agri-cruiser/agri-cruiser/docs/figures/Intro_Figure.jpeg

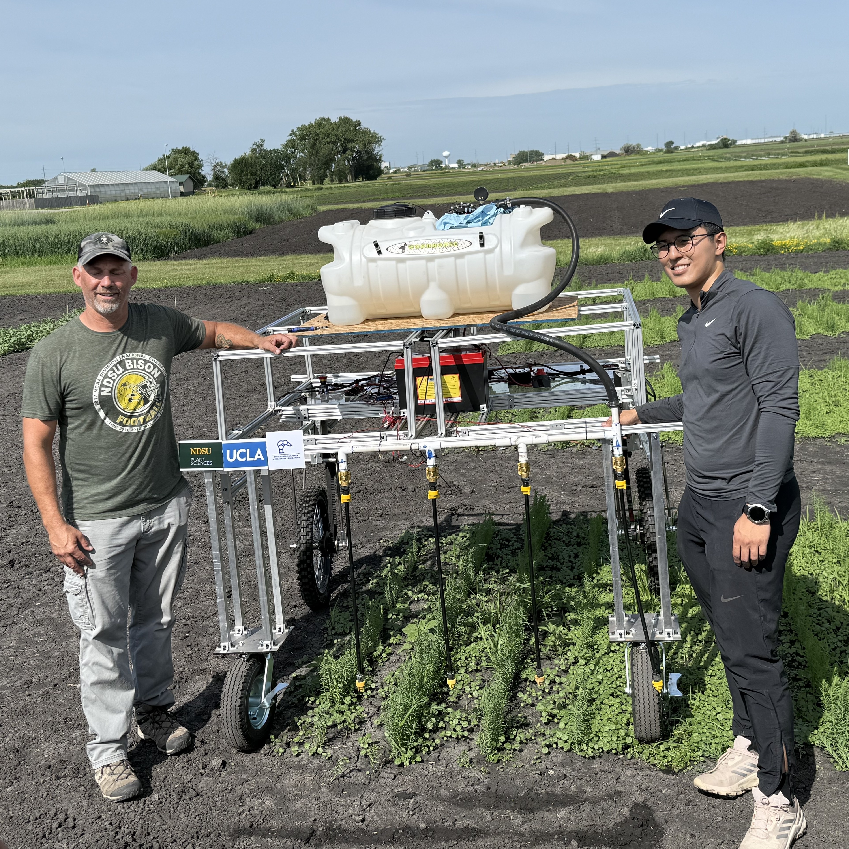
docs/figures/Intro_Figure.jpeg
