agri-cruiser/agri-cruiser/docs/figures/Jason_Irie.webp

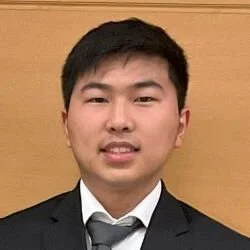
docs/figures/Jason_Irie.webp
