agri-cruiser/agri-cruiser/docs/figures/Jony_Mohammad.jpg

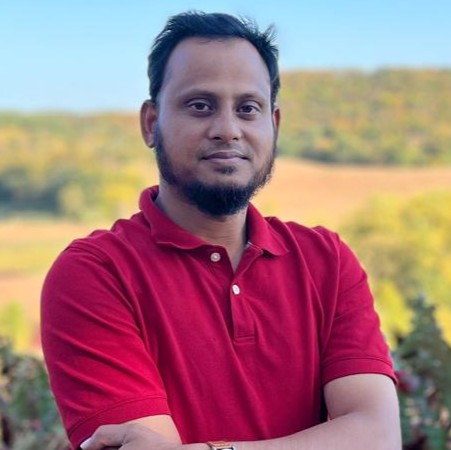
docs/figures/Jony_Mohammad.jpg
