agri-cruiser/agri-cruiser/docs/figures/Kenny_Truong.webp

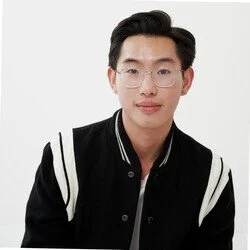
docs/figures/Kenny_Truong.webp
