agri-cruiser/agri-cruiser/docs/figures/Khalid_Jawed.jpg

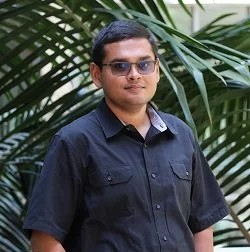
docs/figures/Khalid_Jawed.jpg
