agri-cruiser/agri-cruiser/docs/figures/Main.jpg

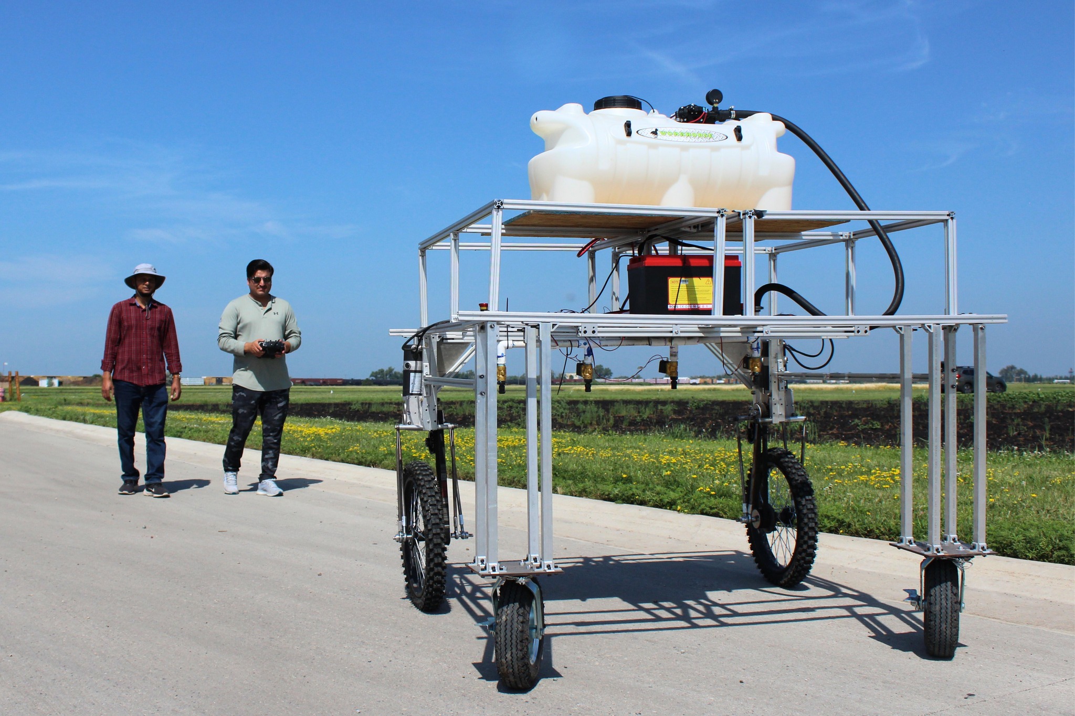
docs/figures/Main.jpg
