agri-cruiser/agri-cruiser/docs/figures/Mukhlesur_Rahman.png

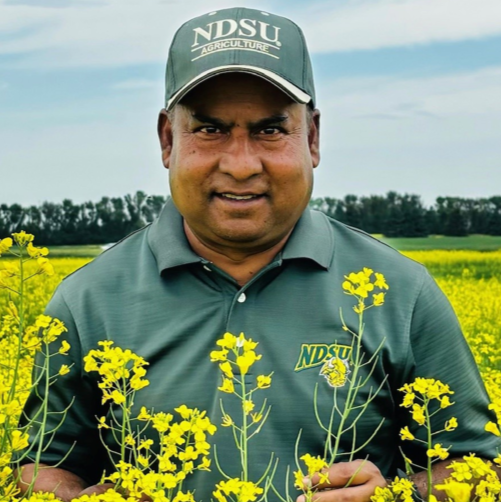
docs/figures/Mukhlesur_Rahman.png
