agri-cruiser/agri-cruiser/docs/figures/Overview.png

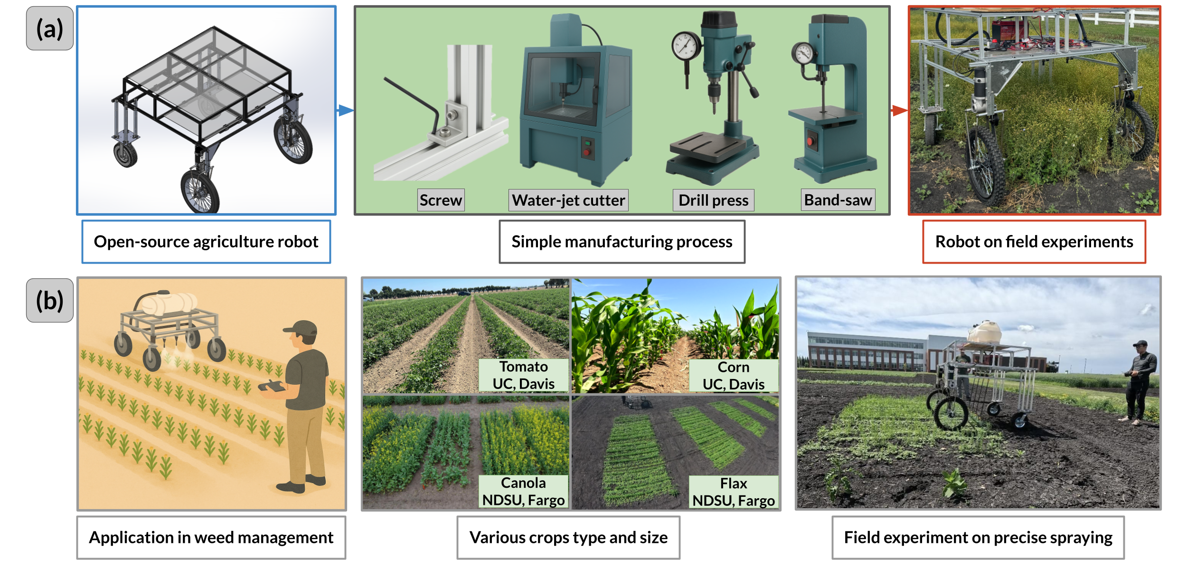
docs/figures/Overview.png
