agri-cruiser/agri-cruiser/docs/figures/Shahab_Ahmad.jpg

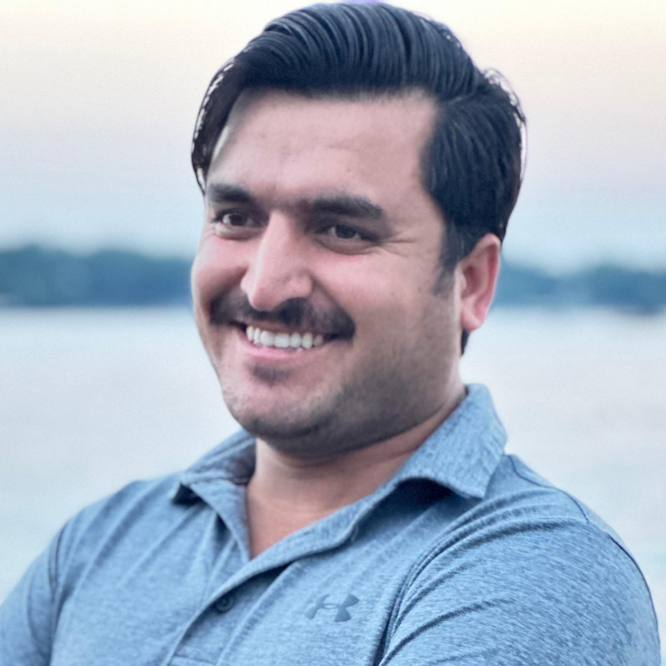
docs/figures/Shahab_Ahmad.jpg
