agri-cruiser/agri-cruiser/docs/figures/Shivam_Panda.webp

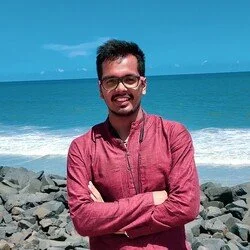
docs/figures/Shivam_Panda.webp
