agri-cruiser/agri-cruiser/docs/figures/Yongkyu_Lee.webp

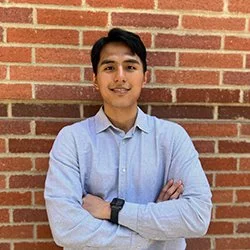
docs/figures/Yongkyu_Lee.webp
