agri-cruiser/agri-cruiser/ESP32-Code/MainRobotCode.ino

#include <esp_now.h>
#include <WiFi.h>
#include "RoboClaw.h"
#include <HardwareSerial.h>

// Relay pins for solenoid control
#define RELAY_PIN1  5
#define RELAY_PIN2  18
#define RELAY_PIN3  19
#define RELAY_PIN4  21

// RoboClaw motor controller address
#define ROBOCLAW_ADDR 0x80

// UART2 for RoboClaw (pins 16 = RX, 17 = TX) to communicate with RoboClaw
HardwareSerial serial2(2); 
RoboClaw roboclaw(&serial2, 10000);

// MAC address of peer ESP32 for ESP-NOW communication (Optional if wanting to communicate with other ESP32)
uint8_t receiverAddress[] = { 0xAC, 0x15, 0x18, 0xD8, 0xD0, 0xD8 };

// Struct for incoming motor + solenoid commands to recieve commands
typedef struct struct_message {
  int speed1;
  int speed2;
  bool solenoid1;
  bool solenoid2;
  bool solenoid3;
  bool solenoid4;
} struct_message;

// Struct for outgoing telemetry (encoders, voltage, motor speeds) 
typedef struct struct_message1 {
  int enc1;
  int enc2;
  float voltage;
  float speedL;
  float speedR;
} struct_message1;

struct_message1 sendingData;
struct_message incomingData;

// Status LED pin (optional)
const int ledPin = 2;

// Encoder counts per revolution
#define CPR 4000  // 1000 lines * 4 (quadrature)

// Motor control scaling constants
int MAX_SPEED = 35000;
int MAX_TURN = 35000;
int MAX_PWM_F = 64;
int MAX_PWM_T = 32; 

// Buffer for CRSF packets from RC receiver
uint8_t crsfBuffer[64];
int crsfPos = 0;

// Callback for handling incoming ESP-NOW data
void onDataRecv(const uint8_t *mac, const uint8_t *incomingDataRaw, int len) {
  memcpy(&incomingData, incomingDataRaw, sizeof(incomingData));

  // Print received data for debugging
  Serial.printf("M1: %d, M2: %d\n", incomingData.speed1, incomingData.speed2);

  // Control motors based on received speeds from ESP32 
  if(incomingData.speed1 < 0){
    roboclaw.SpeedM1(ROBOCLAW_ADDR, incomingData.speed1);
  }else{
    roboclaw.SpeedM1(ROBOCLAW_ADDR, incomingData.speed1);
  }

  if(incomingData.speed2 < 0){
    roboclaw.SpeedM2(ROBOCLAW_ADDR, incomingData.speed2);
  }else{
    roboclaw.SpeedM2(ROBOCLAW_ADDR, incomingData.speed2);
  }

  // If speed is zero, ensure motor is stopped
  if(incomingData.speed1 == 0){
    roboclaw.ForwardM1(ROBOCLAW_ADDR, 0);
  }
  if(incomingData.speed2 == 0){
    roboclaw.ForwardM2(ROBOCLAW_ADDR, 0);
  }
  
  // Read encoder values
  uint32_t enc1, enc2;
  bool valid1, valid2;
  enc1 = roboclaw.ReadEncM1(ROBOCLAW_ADDR, NULL, &valid1);
  enc2 = roboclaw.ReadEncM2(ROBOCLAW_ADDR, NULL, &valid2);

  // Read battery voltage
  bool valid3;
  uint16_t volts = roboclaw.ReadMainBatteryVoltage(ROBOCLAW_ADDR);

  // Prepare telemetry data
  struct_message1 telemetry;
  telemetry.enc1 = valid1 ? enc1 : -1;
  telemetry.enc2 = valid2 ? enc2 : -1;

  float x = volts/10.0;

  telemetry.voltage = x;

  // Solenoid control through relay pins
  if(incomingData.solenoid1){
    digitalWrite(RELAY_PIN1, HIGH);  // Turn relay OFF (active-low relay)
  }
  else{
    digitalWrite(RELAY_PIN1, LOW);
  }
  if(incomingData.solenoid2){
    digitalWrite(RELAY_PIN2, HIGH);  // Turn relay OFF (active-low relay)
  }
  else{
    digitalWrite(RELAY_PIN2, LOW);
  }
  if(incomingData.solenoid3){
    digitalWrite(RELAY_PIN3, HIGH);  // Turn relay OFF (active-low relay)
  }
  else{
    digitalWrite(RELAY_PIN3, LOW);
  }
  if(incomingData.solenoid4){
    digitalWrite(RELAY_PIN4, HIGH);  // Turn relay OFF (active-low relay)
  }
  else{
    digitalWrite(RELAY_PIN4, LOW);
  }

  // Read motor speeds in counts/sec
  bool valid4, valid5;
  int32_t speed1 = roboclaw.ReadSpeedM1(ROBOCLAW_ADDR,NULL, &valid4);  // counts/sec
  int32_t speed2 = roboclaw.ReadSpeedM2(ROBOCLAW_ADDR,NULL, &valid5);  // counts/sec

  telemetry.speedL = speed1;
  telemetry.speedR = speed2;

  // Send back to sender
  esp_now_send(mac, (uint8_t *)&telemetry, sizeof(telemetry));
}

void setup() {
  Serial.begin(115200);

  // Initialize Serial1 for CRSF receiver (pins 22 = RX, 23 = TX)
  Serial1.begin(420000, SERIAL_8N1, 22, 23); // CRSF UART

  // Initialize relay pins
  pinMode(RELAY_PIN1, OUTPUT);     // Set the relay pin as output
  digitalWrite(RELAY_PIN1, LOW);  // Turn relay OFF (active-low relay)

  pinMode(RELAY_PIN2, OUTPUT);     // Set the relay pin as output
  digitalWrite(RELAY_PIN2, LOW);  // Turn relay OFF (active-low relay)

  pinMode(RELAY_PIN3, OUTPUT);     // Set the relay pin as output
  digitalWrite(RELAY_PIN3, LOW);  // Turn relay OFF (active-low relay)

  pinMode(RELAY_PIN4, OUTPUT);     // Set the relay pin as output
  digitalWrite(RELAY_PIN4, LOW);  // Turn relay OFF (active-low relay)

  // Initialize RoboClaw
  serial2.begin(38400, SERIAL_8N1, 16, 17);
  roboclaw.begin(38400);

  // Initialize ESP-NOW
  WiFi.mode(WIFI_STA);
  WiFi.disconnect();

  // Check if ESP32 now is working (optional)
  if (esp_now_init() != ESP_OK) {
    Serial.println("ESP-NOW init failed");
    return;
  }

  // Registers the peers 
  esp_now_peer_info_t peerInfo = {};
  memcpy(peerInfo.peer_addr, receiverAddress, 6);
  
  peerInfo.channel = 0;
  peerInfo.encrypt = false;

  // Checks if the peer is added successfully
  if (esp_now_add_peer(&peerInfo) != ESP_OK) {
    Serial.println("Failed to add peer");
    return;
  }
  else{
    esp_now_register_recv_cb(onDataRecv);
  }
}

void loop() {
  // Read CRSF packets from Serial1 (CRSF Receiver)
  while (Serial1.available()) {
    // Read a byte from Serial1
    uint8_t byte = Serial1.read();

    // Detect start of CRSF packets
    if (crsfPos == 0 && byte != 0xC8) continue;

    // Store byte in buffer
    crsfBuffer[crsfPos++] = byte;

    // Check if we have received the full packet
    if (crsfPos > 2 && crsfPos >= crsfBuffer[1] + 2) {
      parseCRSFPacket(crsfBuffer, crsfPos);
      crsfPos = 0;
    }
  }
  delay(10);
}

// Parse CRSF packet and control motors/solenoids
void parseCRSFPacket(uint8_t *data, int len) {
  if (data[2] == 0x16) { // RC Channels frame
    uint16_t channels[16];
    uint8_t *p = &data[3];

    // Extract 11-bit channel values
    channels[0] = ((p[0] | p[1] << 8) & 0x07FF);
    channels[1] = ((p[1] >> 3 | p[2] << 5) & 0x07FF);
    channels[2] = ((p[2] >> 6 | p[3] << 2 | p[4] << 10) & 0x07FF);
    channels[3] = ((p[4] >> 1 | p[5] << 7) & 0x07FF);
    channels[4] = ((p[5] >> 4 | p[6] << 4) & 0x07FF);
    channels[5] = ((p[6] >> 7 | p[7] << 1 | p[8] << 9) & 0x07FF);
    channels[6] = ((p[8] >> 2 | p[9] << 6) & 0x07FF);
    channels[7] = ((p[9] >> 5 | p[10] << 3) & 0x07FF);
    channels[8]  = ((p[11] | p[12] << 8) & 0x07FF);
    channels[9]  = ((p[12] >> 3 | p[13] << 5) & 0x07FF);
    channels[10] = ((p[13] >> 6 | p[14] << 2 | p[15] << 10) & 0x07FF);

    // Map channels to -1.0 to 1.0 range
    float ch1 = ((channels[1] - 992.0f) / 820.0f); // Throttle
    float ch2 = ((channels[3] - 992.0f) / 820.0f); // Steering

    // Clamp values to -1.0 to 1.0
    ch1 = constrain(ch1, -1.0f, 1.0f);
    ch2 = constrain(ch2, -1.0f, 1.0f);

    // Optionally: Apply deadzone
    float deadzone = 0.05;
    if (fabs(ch1) < deadzone) ch1 = 0;
    if (fabs(ch2) < deadzone) ch2 = 0;

    // Convert to Speed values for RoboClaw that uses PID
    float forward = ch1 * MAX_SPEED;
    float turn = -ch2 * MAX_TURN;

    // Calculate individual motor speeds
    int leftSpeed = forwardSpeed + turnSpeed;
    int rightSpeed = forwardSpeed - turnSpeed;

    // Drive motors using Speed-style control
    if(leftSpeed < 0){
      roboclaw.SpeedM1(ROBOCLAW_ADDR, -leftSpeed);
    }else{
      roboclaw.SpeedM1(ROBOCLAW_ADDR, leftSpeed);
    }
    if(rightSpeed < 0){
      roboclaw.SpeedM2(ROBOCLAW_ADDR, -rightSpeed);
    }else{
      roboclaw.SpeedM2(ROBOCLAW_ADDR, rightSpeed);
    }

    // Map switches to solenoids
    if (channels[6] > 1500) {  // Or adjust threshold as needed
      Serial.println("Active 1");
      digitalWrite(RELAY_PIN1, HIGH);  // Turn relay OFF (active-low relay)
    } else {
      Serial.println("NOT ACTIVE 1");
      digitalWrite(RELAY_PIN1, LOW);  // Turn relay OFF (active-low relay)
    }
    if (channels[7] > 1500) {  // Or adjust threshold as needed
      Serial.println("Active 2");
      digitalWrite(RELAY_PIN2, HIGH);  // Turn relay OFF (active-low relay)
    } else {
      Serial.println("NOT ACTIVE 2");
      digitalWrite(RELAY_PIN2, LOW);  // Turn relay OFF (active-low relay)
    }
    if (channels[8] > 1500) {  // Or adjust threshold as needed
      Serial.println("Active 3");
      digitalWrite(RELAY_PIN3, HIGH);  // Turn relay OFF (active-low relay)
    } else {
      Serial.println("NOT ACTIVE 3");
      digitalWrite(RELAY_PIN3, LOW);  // Turn relay OFF (active-low relay)
    }
    if (channels[9] > 1500) {  // Or adjust threshold as needed
      Serial.println("Active 4");
      digitalWrite(RELAY_PIN4, HIGH);  // Turn relay OFF (active-low relay)
    } else {
      Serial.println("NOT ACTIVE 4");
      digitalWrite(RELAY_PIN4, LOW);  // Turn relay OFF (active-low relay)
    }
  }
}
