agri-cruiser/agri-cruiser/(commit log)

2025-09-23 Added in the MainRobotCode for ESP32
2025-09-23 fixing/editing the comments for the code
    [MainRobotCode.ino]
2025-09-23 Removed unecessary code and fixed formatting
    [MainRobotCode.ino]
2025-09-23 Fixing code with better word choice
    [MainRobotCode.ino]
2025-09-23 update the code with correct values and information
    [MainRobotCode.ino]
2025-09-23 Add circuit diagram to github
2025-09-23 Create BOM Details
